Lysoll/Noodles/button-box/lid.stl

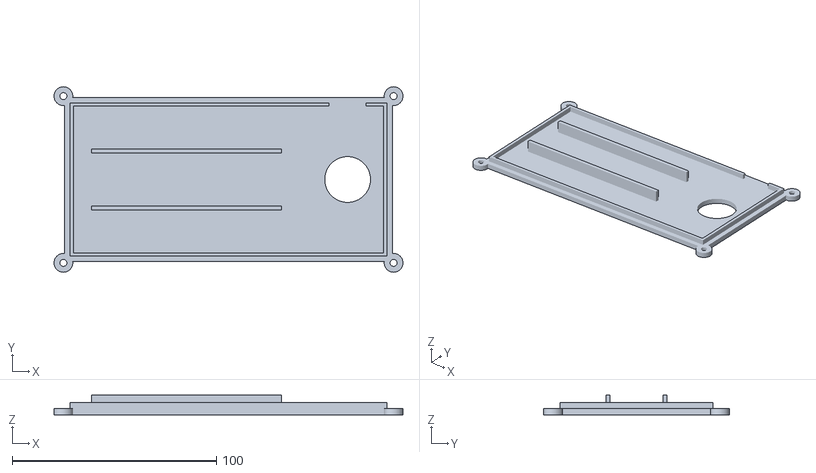
[picture p3: CAD file, 2026-10-02]
button-box/lid.stl
170.8 x 90.8 x 9.60
