Lysoll/Noodles/button-box/base.stl

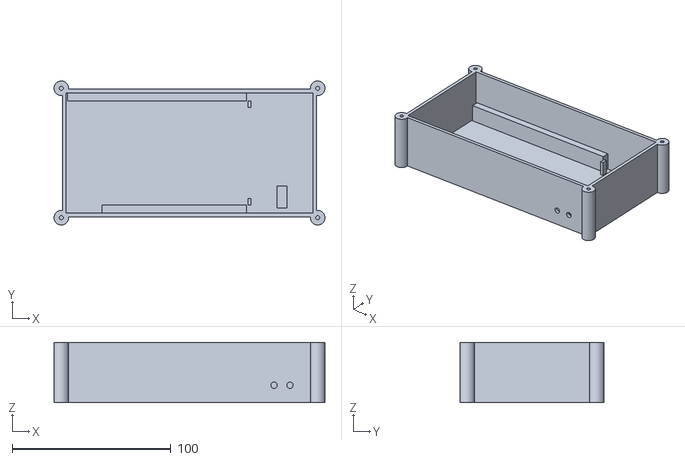
[picture p4: CAD file, 2026-10-02]
button-box/base.stl
170.8 x 90.8 x 38.0
