Lysoll/Noodles/(commit log)

2026-10-02 Add 3D-printable housing for 8xAA battery holder and 22mm push button
    Parametric OpenSCAD model plus ready-to-print base/lid STLs sized for a
    Creality K1 SE, with two wire exit holes and a zip-tie strain relief.
    Claude-Session: https://claude.ai/code/session_01Ln2yW8a7jHPSrMqoMoXPFp
    [base.stl, button_box.scad, lid.stl]
2026-10-02 Add battery-holder ON/OFF switch window to housing
    Holder now sits with its switch end against the X=0 wall; a flared
    window gives fingertip access. Side spacer on the lead-wire side starts
    22 mm in so the holder's leads can route along the gap to the button.
    Switch position is parametric (sw_from_edge, sw_from_bottom).
    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
    [base.stl, button_box.scad, lid.stl]
